ramselvaraj/rv32-linux/(commit log)

2026-10-24 RV32IMA Linux-capable core: pipeline, privileged ISA, Sv32 MMU, OpenSBI boot
    5-stage in-order RV32IMA_Zicsr_Zifencei core in SystemVerilog with M/S/U modes,
    trap delegation, CLINT-style interrupts, Sv32 (iTLB/dTLB + hardware walker).
    Verified in Verilator: 139/139 riscv-tests ISA binaries (incl. all virtual-memory
    variants) at zero and random memory latency, a divide regression, and an OpenSBI
    boot into an S-mode payload exercising SBI calls, a delegated timer interrupt,
    paging and page faults.
2026-10-30 FPGA SoC for PYNQ-Z2: AXI bridges, serial UART, Vivado flow, on-board bring-up
    Adds rtl/soc (AXI3 master bridges to Zynq HP0/HP1, 16550 UART, CLINT, rv_soc top with an
    EMIO debug window), a batch Vivado build for the PYNQ-Z2 (50 MHz, timing met), a Verilator
    bench with an AXI memory model (make test-soc) and an on-board loader.
    Bring-up fixes: HP ports power up 64-bit and must be set to 32-bit (AFI FabricWidth) before
    the core runs; the bridge keeps rready/bready high so stale responses drain after a reset.
    Core: wstrb is now the byte-lane mask on reads too (UART RX FIFO pop). OpenSBI and the
    S-mode payload run to completion on the board.
    [axi_ram.sv, pynq_z2.xdc, run_on_board.py, rv_core.sv, rv_csr.sv, rv_dmux.sv, rv_fetch.sv, rv_soc.sv]
2026-10-30 Boot Linux 6.18 on the PYNQ-Z2 core: Buildroot config, board DTS, firmware packaging, DDR kernel-log reader
2026-10-30 README: Linux boots on the board; build and log-reading instructions
